omar3hany/Arduino-car/(list of files, drawings)

Other design files:
project.fzz
