omar3hany/Arduino-car/joystick/joystick.ino

int VRx = A0;
int VRy = A1;
//int SW = 2;

int xPosition = 0;
int yPosition = 0;
//int SW_state = 0;
int mapX = 0;
int mapY = 0;

void setup() {
  Serial.begin(9600); 
  pinMode(13,OUTPUT);
  pinMode(VRx, INPUT);
  pinMode(VRy, INPUT);
  //pinMode(SW, INPUT_PULLUP); 
  
}

void loop() {
  digitalWrite(13,HIGH);
  xPosition = analogRead(VRx);
  yPosition = analogRead(VRy);
 // SW_state = digitalRead(SW);
  mapX = map(xPosition, 0, 1023, -512, 512);
  mapY = map(yPosition, 0, 1023, -512, 512);
  
  Serial.print("X: ");
  Serial.print(mapX);
  Serial.print(" | Y: ");
  Serial.print(mapY);
  Serial.println(" | Button: ");
  //Serial.println(SW_state);

  delay(1000);
  
}
